apmarshall3/general-purpose-robotics-shield/PCB_V2/model3d/L298P.stp

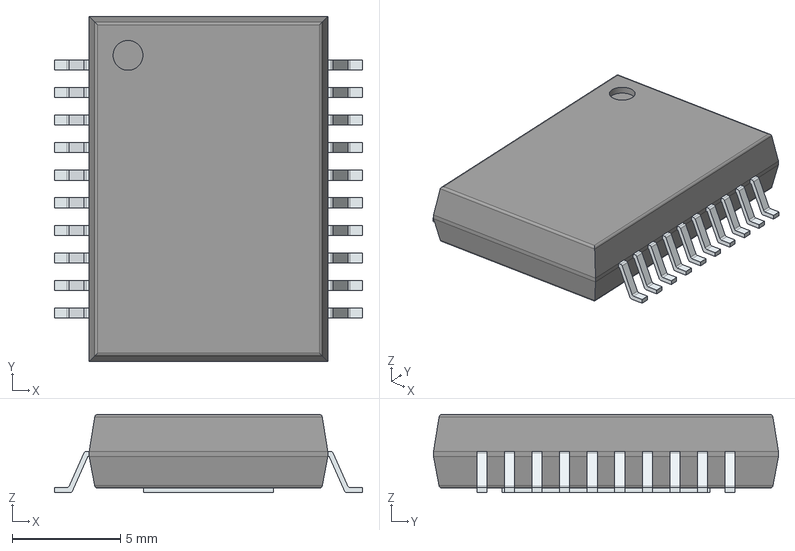
[picture p1: CAD file, 2024-03-01]
PCB_V2/model3d/L298P.stp
14.2 x 15.9 x 3.60 mm
PinsArrayLR
ThermalPad
