apmarshall3/general-purpose-robotics-shield/PCB_V2/model3d/Molex_90Grad_8er.STEP

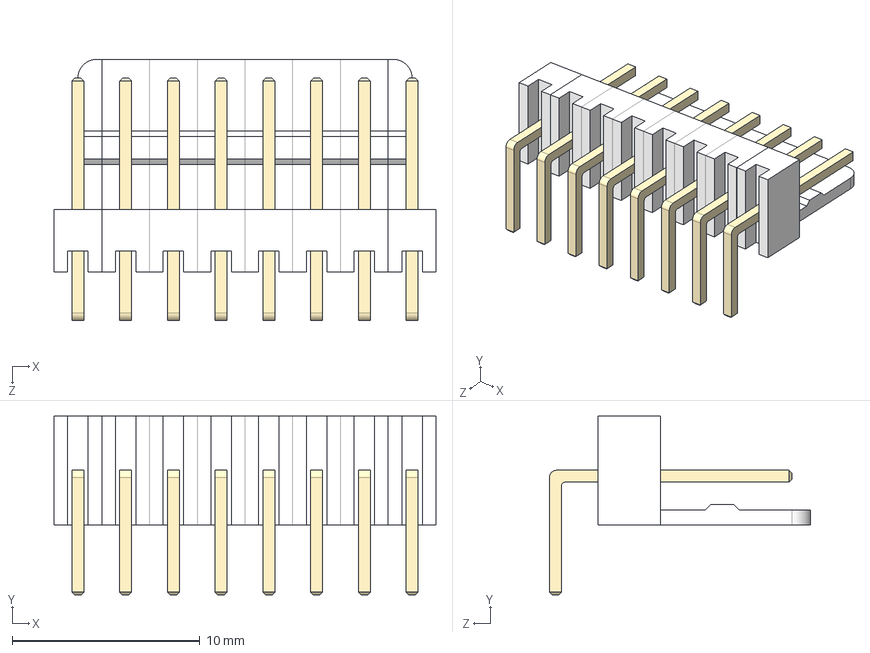
[picture p6: CAD file, 2024-02-28]
PCB_V2/model3d/Molex_90Grad_8er.STEP
20.3 x 9.52 x 13.9 mm
Molex_Stecker_90Grad_rechts
Molex_Stecker_90Grad_links
Molex_Stecker_90Grad_mitte x 6
