apmarshall3/general-purpose-robotics-shield/(list of files, cad)

Other CAD files:
PCB_V2/Shield_offset-B_Paste.dxf
PCB_V2/Shield_offset-F_Paste.dxf
