apmarshall3/general-purpose-robotics-shield/PCB_V2/Shield_offset.kicad_pcb

## KiCad design PCB_V2/Shield_offset.kicad_pcb (2026-07-02)

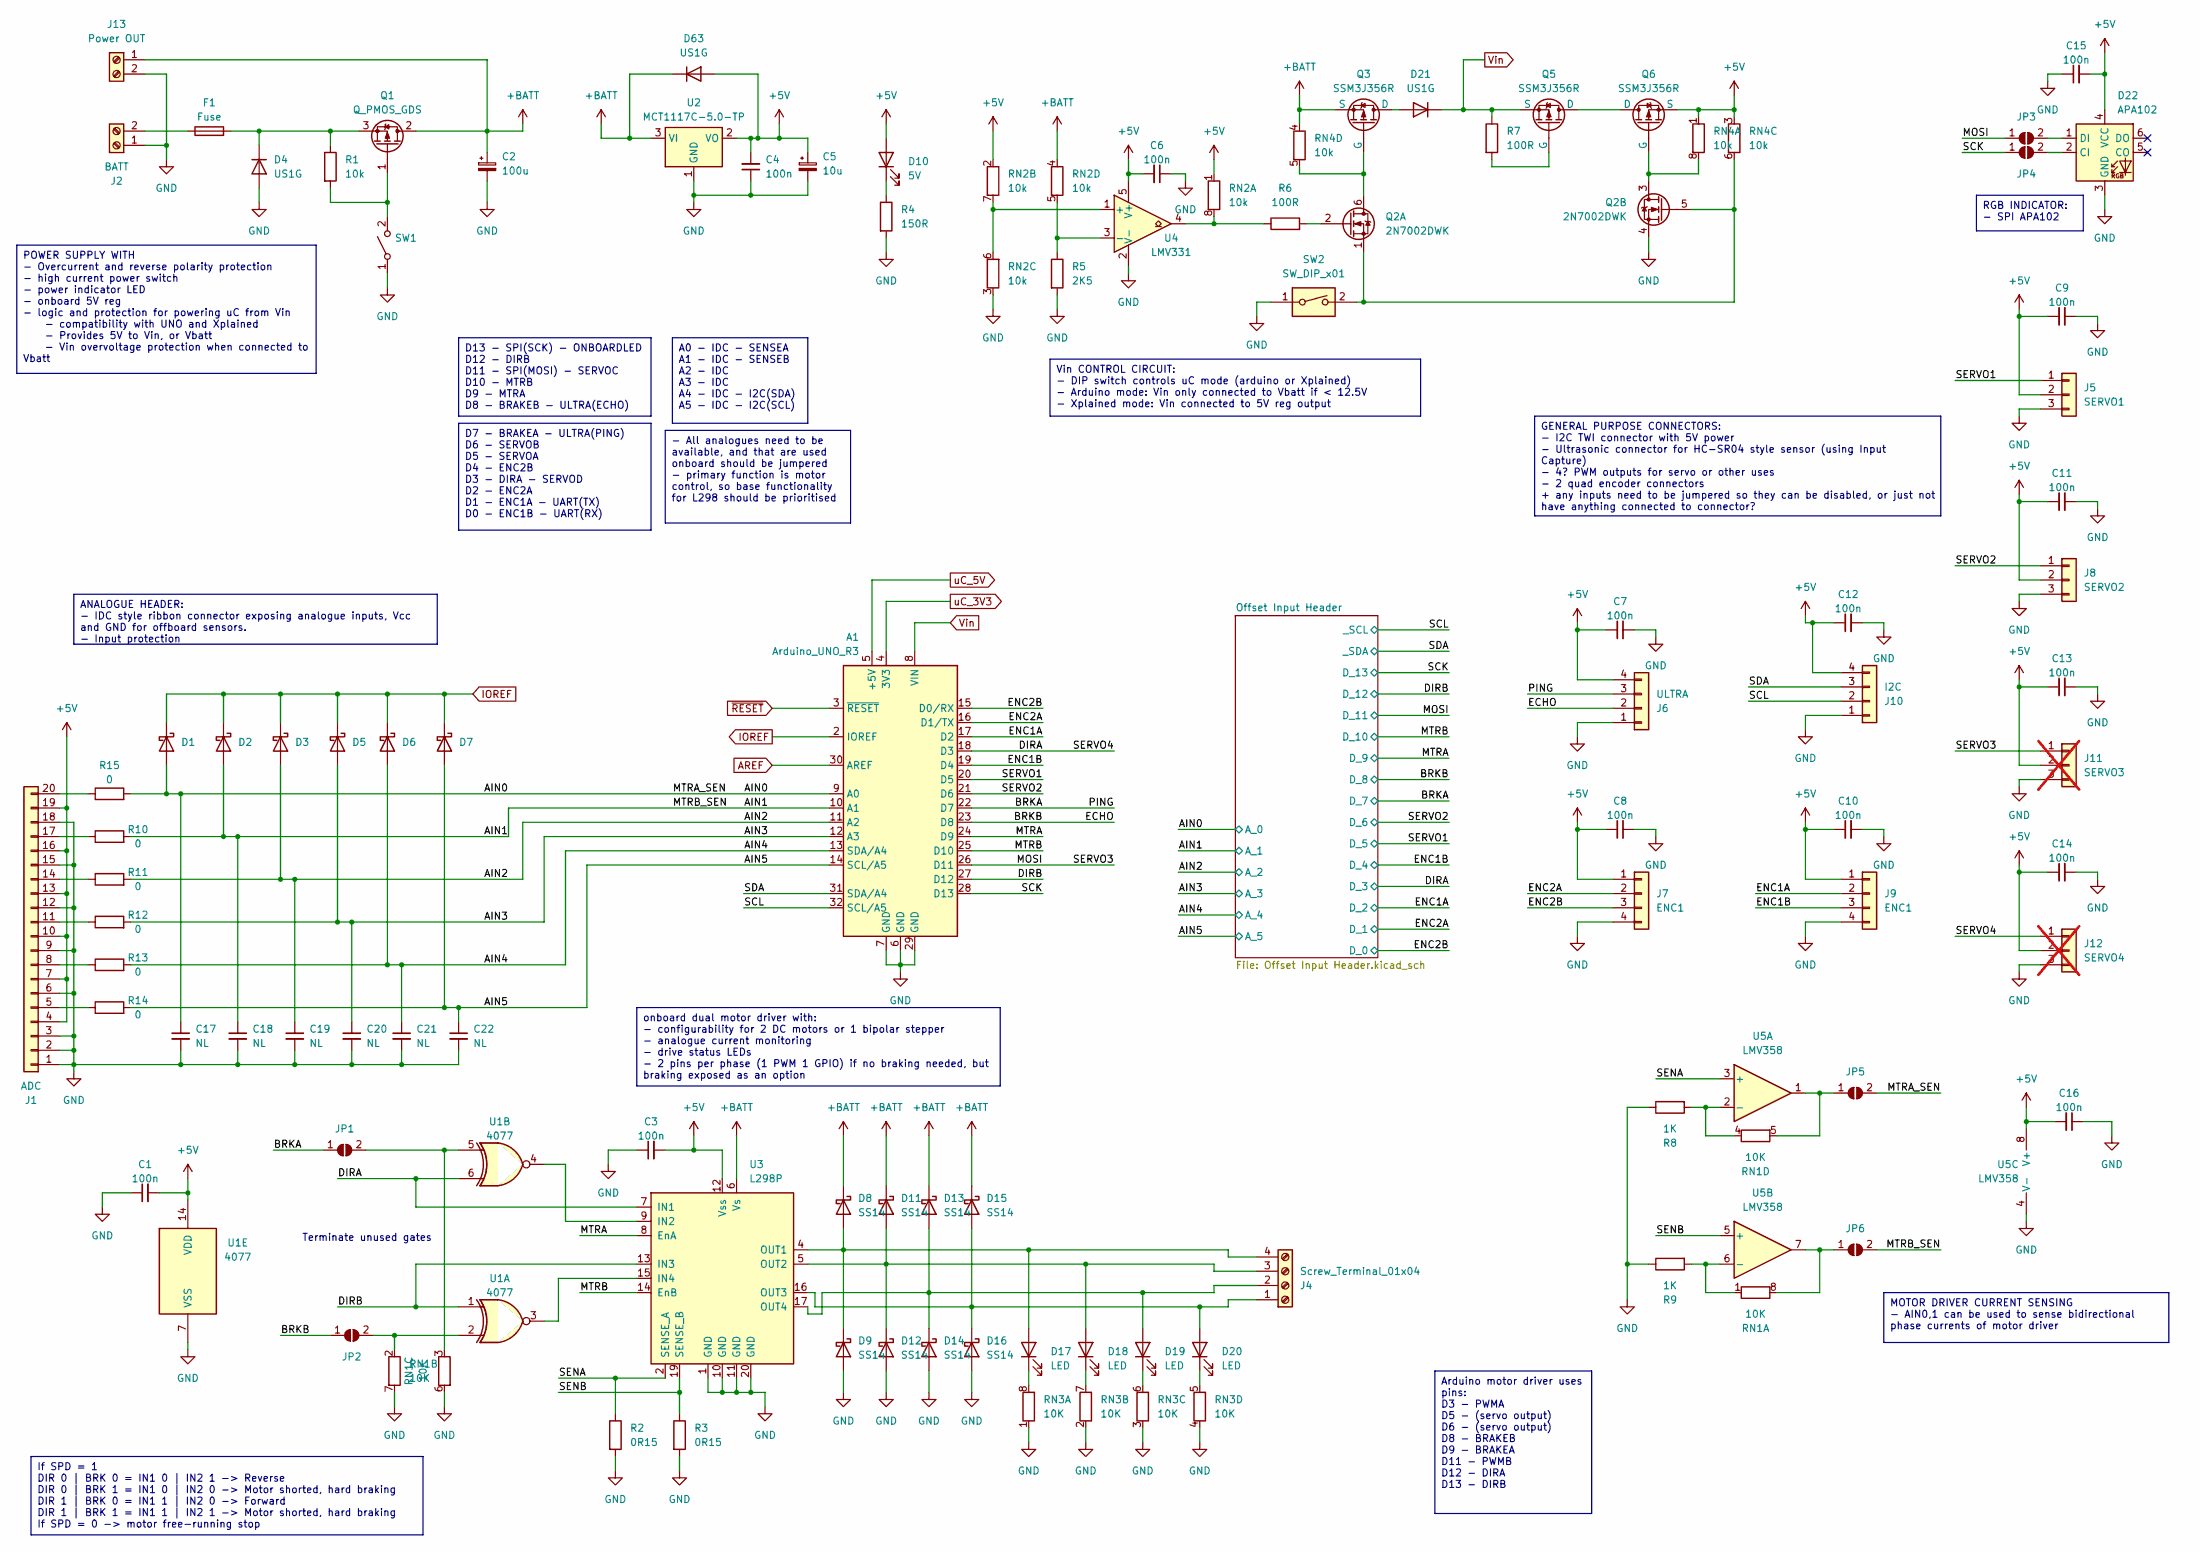
[picture p11: schematic Shield_offset.kicad_sch]

Parts:
A1: Arduino_UNO_R3
C1, C3, C4, C6, C7, C8, C9, C10, C11, C12, C13, C14, C15, C16: 100n; C_0805_2012Metric_Pad1.18x1.45mm_HandSolder
C2: 100u; CP_Elec_6.3x7.7; Manuf Part# HHXJ350ARA101MF80G
C5: 10u; CP_Elec_6.3x5.7
C17, C18, C19, C20, C21, C22: NL; C_0805_2012Metric_Pad1.18x1.45mm_HandSolder
D1, D2, D3, D5, D6, D7: CDBW140-G; D_SOD-123
D4, D21, D63: US1G; D_SMA
D8, D9, D11, D12, D13, D14, D15, D16: SS14; D_SMA
D10: 5V; LED_0805_2012Metric_Pad1.15x1.40mm_HandSolder
D17, D18, D19, D20: LED; LED_0805_2012Metric_Pad1.15x1.40mm_HandSolder
D22: APA102; LED_RGB_5050-6
F1: Fuse; Fuseholder_Clip-5x20mm_Littelfuse_445-030_Inline_P20.50x5.2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
J1: ADC; IDC-Header_2x10_P2.54mm_Vertical
J2: BATT; Amass_XT60PW-M_Kombifootprint
J4: Screw_Terminal_01x04; TerminalBlock_Phoenix_MKDS-1,5-4-5.08_1x04_P5.08mm_Horizont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
J5: SERVO1; PinHeader_1x03_P2.54mm_Vertical
J6: ULTRA; Molex_KK-254_1x04_P2.54mm_Horizontal
J7, J9: ENC1; Molex_KK-254_AE-6410-04A_1x04_P2.54mm_Vertical
J8: SERVO2; PinHeader_1x03_P2.54mm_Vertical
J10: I2C; Molex_KK-254_1x04_P2.54mm_Horizontal
J11: SERVO3; PinHeader_1x03_P2.54mm_Vertical; not fitted
J12: SERVO4; PinHeader_1x03_P2.54mm_Vertical; not fitted
J13: Power OUT; TerminalBlock_Phoenix_MKDS-1,5-2-5.08_1x02_P5.08mm_Horizont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
JP1, JP2, JP3, JP4, JP5, JP6: SolderJumper_2_Open; SolderJumper-2_P1.3mm_Open_RoundedPad1.0x1.5mm
Q1: Q_PMOS_GDS; SOT-223-3_TabPin2
Q2: 2N7002DWK; SOT-363_SC-70-6_Handsoldering
Q3, Q5, Q6: SSM3J356R; SOT-23-3
R1: 10k; R_0805_2012Metric_Pad1.20x1.40mm_HandSolder
R2, R3: 0R15; R_1206_3216Metric_Pad1.30x1.75mm_HandSolder
R4: 150R; R_0805_2012Metric_Pad1.20x1.40mm_HandSolder
R5: 2K5; R_0805_2012Metric_Pad1.20x1.40mm_HandSolder
R6, R7: 100R; R_0805_2012Metric_Pad1.20x1.40mm_HandSolder
R8, R9: 1K; R_0805_2012Metric_Pad1.20x1.40mm_HandSolder
R10, R11, R12, R13, R14, R15: 0; R_0603_1608Metric
RN1, RN3: 10K; R_Array_Convex_4x0603
RN2, RN4: 10k; R_Array_Convex_4x0603
SW1: PWR SW; SW_E-Switch_EG2219_DPDT_Angled
SW2: SW_DIP_x01; SW_DIP_SPSTx01_Slide_9.78x4.72mm_W8.61mm_P2.54mm
U1: 4077; SOIC-14_3.9x8.7mm_P1.27mm
U2: MCT1117C-5.0-TP; SOT-223-3_TabPin2
U3: L298P; SOIC127P1420X360-21N
U4: LMV331; SOT-353_SC-70-5
U5: LMV358; SOIC-8_3.9x4.9mm_P1.27mm

Connections:
+5V: C1.2, C3.2, C4.2, C5.1, C6.2, C7.1, C8.1, C9.1, C10.1, C11.1, C12.1, C13.1, C14.1, C15.2, C16.2, D10.2 (A), D22.4 (VCC), D63.2 (A), J1.4, J1.7, J1.10, J1.13, J1.16, J1.19, J5.2, J6.4, J7.1, J8.2, J9.1, J10.4, J11.2, J12.2, Q6.2 (S), RN2.1 (R1.1), RN2.2 (R2.1), RN4.1 (R1.1), RN4.3 (R3.1), U1.14 (VDD), U2.2 (VO), U3.12 (Vss), U4.5 (V+), U5.8 (V+)
+BATT: C2.1, D8.1 (K), D11.1 (K), D13.1 (K), D15.1 (K), D63.1 (K), J13.1, Q1.2 (D), Q3.2 (S), RN2.4 (R4.1), RN4.4 (R4.1), U2.3 (VI), U3.6 (Vs)
/AIN0: A1.9 (A0), C17.1, D1.2 (A), JP5.2 (B), R15.2; also elsewhere on the board
/AIN1: A1.10 (A1), C18.1, D2.2 (A), JP6.2 (B), R10.2; also elsewhere on the board
/AIN2: A1.11 (A2), C19.1, D3.2 (A), R11.2; also elsewhere on the board
/AIN3: A1.12 (A3), C20.1, D5.2 (A), R12.2; also elsewhere on the board
/AIN4: A1.13 (SDA/A4), C21.1, D6.2 (A), R13.2; also elsewhere on the board
/AIN5: A1.14 (SCL/A5), C22.1, D7.2 (A), R14.2; also elsewhere on the board
/BRKA: A1.22 (D7), J6.3, JP1.1 (A); also elsewhere on the board
/BRKB: A1.23 (D8), J6.2, JP2.1 (A); also elsewhere on the board
/DIRA: A1.18 (D3), J12.1, U1.6, U3.7 (IN1); also elsewhere on the board
/DIRB: A1.27 (D12), U1.1, U3.13 (IN3); also elsewhere on the board
/ENC1A: A1.17 (D2), J9.2; also elsewhere on the board
/ENC1B: A1.19 (D4), J9.3; also elsewhere on the board
/ENC2A: A1.16 (D1/TX), J7.2; also elsewhere on the board
/ENC2B: A1.15 (D0/RX), J7.3; also elsewhere on the board
/MOSI: A1.26 (D11), J11.1, JP3.1 (A); also elsewhere on the board
/MTRA: A1.24 (D9), U3.8 (EnA); also elsewhere on the board
/MTRB: A1.25 (D10), U3.14 (EnB); also elsewhere on the board
/SCK: A1.28 (D13), JP4.1 (A); also elsewhere on the board
/SCL: A1.32 (SCL/A5), J10.2; also elsewhere on the board
/SDA: A1.31 (SDA/A4), J10.3; also elsewhere on the board
/SENA: R2.1, U3.2 (SENSE_A), U5.3 (+)
/SENB: R3.1, U3.19 (SENSE_B), U5.5 (+)
/SERVO1: A1.20 (D5), J5.1; also elsewhere on the board
/SERVO2: A1.21 (D6), J8.1; also elsewhere on the board
AREF: A1.30 (AREF); also elsewhere on the board
GND: A1.6 (GND), A1.7 (GND), A1.29 (GND), C1.1, C2.2, C3.1, C4.1, C5.2, C6.1, C7.2, C8.2, C9.2, C10.2, C11.2, C12.2, C13.2, C14.2, C15.1, C16.1, C17.2, C18.2, C19.2, C20.2, C21.2, C22.2, D4.2 (A), D9.2 (A), D12.2 (A), D14.2 (A), D16.2 (A), D22.3 (GND), J1.1, J1.2, J1.3, J1.6, J1.9, J1.12, J1.15, J1.18, J2.1, J5.3, J6.1, J7.4, J8.3, J9.4, J10.1, J11.3, J12.3, J13.2, Q2.4 (S), R2.2, R3.2, R4.2, R5.2, R8.1, R9.1, RN1.6 (R3.2), RN1.7 (R2.2), RN2.3 (R3.1), RN3.1 (R1.1), RN3.2 (R2.1), RN3.3 (R3.1), RN3.4 (R4.1), SW1.1 (A), SW2.1, U1.7 (VSS), U2.1 (GND), U3.1 (GND), U3.10 (GND), U3.11 (GND), U3.20 (GND), U4.2 (V-), U5.4 (V-); also elsewhere on the board
IOREF: A1.2 (IOREF), D1.1 (K), D2.1 (K), D3.1 (K), D5.1 (K), D6.1 (K), D7.1 (K); also elsewhere on the board
unnamed: D4.1 (K), F1.2, Q1.3 (S), R1.1
unnamed: D10.1 (K), R4.1
unnamed: D11.2 (A), D12.1 (K), D18.2 (A), J4.3, U3.5 (OUT2)
unnamed: D13.2 (A), D14.1 (K), D19.2 (A), J4.2, U3.17 (OUT4)
unnamed: D15.2 (A), D16.1 (K), D20.2 (A), J4.1, U3.16 (OUT3)
unnamed: D8.2 (A), D9.1 (K), D17.2 (A), J4.4, U3.4 (OUT1)
unnamed: D17.1 (K), RN3.8 (R1.2)
unnamed: D18.1 (K), RN3.7 (R2.2)
unnamed: D19.1 (K), RN3.6 (R3.2)
unnamed: D20.1 (K), RN3.5 (R4.2)
unnamed: D21.2 (A), Q3.3 (D)
unnamed: D22.2 (CI), JP4.2 (B)
unnamed: D22.1 (DI), JP3.2 (B)
unnamed: J1.5, R14.1
unnamed: J1.8, R13.1
unnamed: J1.11, R12.1
unnamed: J1.14, R11.1
unnamed: J1.17, R10.1
unnamed: J1.20, R15.1
unnamed: F1.1, J2.2
unnamed: JP1.2 (B), RN1.3 (R3.1), U1.5
unnamed: JP2.2 (B), RN1.2 (R2.1), U1.2
unnamed: JP5.1 (A), RN1.5 (R4.2), U5.1
unnamed: JP6.1 (A), RN1.8 (R1.2), U5.7
unnamed: Q1.1 (G), R1.2, SW1.2 (B)
unnamed: Q2.6 (D), Q3.1 (G), RN4.5 (R4.2)
unnamed: Q2.2 (G), R6.2
unnamed: Q2.1 (S), Q2.5 (G), RN4.6 (R3.2), SW2.2
unnamed: Q2.3 (D), Q6.1 (G), RN4.8 (R1.2)
unnamed: Q5.3 (D), Q6.3 (D)
unnamed: Q5.1 (G), R7.2
unnamed: R9.2, RN1.1 (R1.1), U5.6 (-)
unnamed: R8.2, RN1.4 (R4.1), U5.2 (-)
unnamed: R6.1, RN2.8 (R1.2), U4.4
unnamed: RN2.6 (R3.2), RN2.7 (R2.2), U4.1 (+)
unnamed: R5.1, RN2.5 (R4.2), U4.3 (-)
unnamed: U1.4, U3.9 (IN2)
unnamed: U1.3, U3.15 (IN4)
Vin: A1.8 (VIN), D21.1 (K), Q5.2 (S), R7.1; also elsewhere on the board
uC_3V3: A1.4 (3V3); also elsewhere on the board
uC_5V: A1.5 (+5V); also elsewhere on the board
~RESET: A1.3 (~RESET); also elsewhere on the board

Notes on the sheet:
D7 - BRAKEA - ULTRA(PING) D6 - SERVOB D5 - SERVOA D4 - ENC2B D3 - DIRA - SERVOD D2 - ENC2A D1 - ENC1A - UART(TX) D0 - ENC1B - UART(RX)
D13 - SPI(SCK) - ONBOARDLED D12 - DIRB D11 - SPI(MOSI) - SERVOC D10 - MTRB D9 - MTRA D8 - BRAKEB - ULTRA(ECHO)
RGB INDICATOR: - SPI APA102
Vin CONTROL CIRCUIT: - DIP switch controls uC mode (arduino or Xplained) - Arduino mode: Vin only connected to Vbatt if < 12.5V - Xplained mode: Vin connected to 5V reg output
Arduino motor driver uses pins: D3 - PWMA D5 - (servo output) D6 - (servo output) D8 - BRAKEB D9 - BRAKEA D11 - PWMB D12 - DIRA D13 - DIRB
- All analogues need to be available, and that are used onboard should be jumpered - primary function is motor control, so base functionality for L298 should be prioritised
POWER SUPPLY WITH - Overcurrent and reverse polarity protection - high current power switch - power indicator LED - onboard 5V reg - logic and protection for powering uC from Vin - compatibility with UNO and Xplained - Provides 5V to Vin, or Vbatt - Vin overvoltage protection when connected to Vbatt
A0 - IDC - SENSEA A1 - IDC - SENSEB A2 - IDC A3 - IDC A4 - IDC - I2C(SDA) A5 - IDC - I2C(SCL)
ANALOGUE HEADER: - IDC style ribbon connector exposing analogue inputs, Vcc and GND for offboard sensors. - Input protection
If SPD = 1 DIR 0 | BRK 0 = IN1 0 | IN2 1 -> Reverse DIR 0 | BRK 1 = IN1 0 | IN2 0 -> Motor shorted, hard braking DIR 1 | BRK 0 = IN1 1 | IN2 0 -> Forward DIR 1 | BRK 1 = IN1 1 | IN2 1 -> Motor shorted, hard braking If SPD = 0 -> motor free-running stop
onboard dual motor driver with: - configurability for 2 DC motors or 1 bipolar stepper - analogue current monitoring - drive status LEDs - 2 pins per phase (1 PWM 1 GPIO) if no braking needed, but braking exposed as an option
GENERAL PURPOSE CONNECTORS: - I2C TWI connector with 5V power - Ultrasonic connector for HC-SR04 style sensor (using Input Capture) - 4? PWM outputs for servo or other uses - 2 quad encoder connectors + any inputs need to be jumpered so they can be disabled, or just not have anything connected to c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
MOTOR DRIVER CURRENT SENSING - AIN0,1 can be used to sense bidirectional phase currents of motor driver
Terminate unused gates

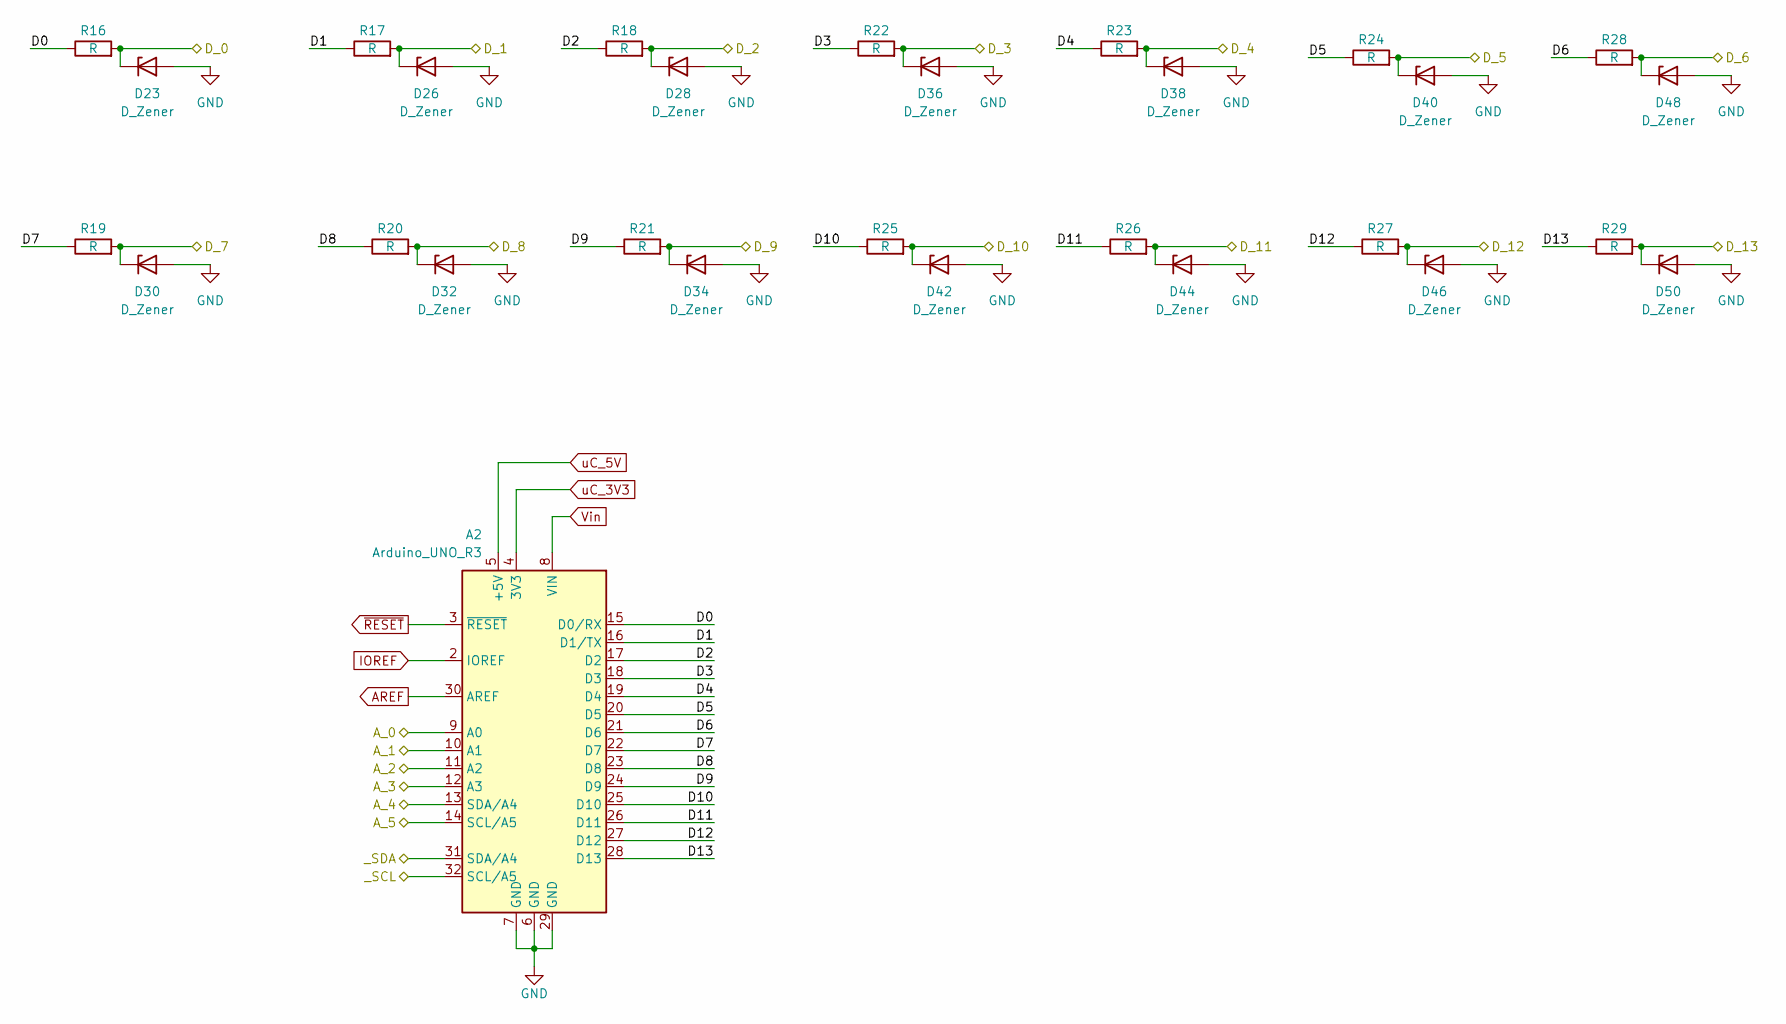
[picture p12: schematic Offset Input Header.kicad_sch]

Parts:
A2: Arduino_UNO_R3
D23, D26, D28, D30, D32, D34, D36, D38, D40, D42, D44, D46, D48, D50: D_Zener; D_SOD-123
R16, R17, R18, R19, R20, R21, R22, R23, R24, R25, R26, R27, R28, R29: R; R_0805_2012Metric

Connections:
/AIN0: A2.9 (A0); also elsewhere on the board
/AIN1: A2.10 (A1); also elsewhere on the board
/AIN2: A2.11 (A2); also elsewhere on the board
/AIN3: A2.12 (A3); also elsewhere on the board
/AIN4: A2.13 (SDA/A4); also elsewhere on the board
/AIN5: A2.14 (SCL/A5); also elsewhere on the board
/BRKA: D30.1 (K), R19.2; also elsewhere on the board
/BRKB: D32.1 (K), R20.2; also elsewhere on the board
/DIRA: D36.1 (K), R22.2; also elsewhere on the board
/DIRB: D46.1 (K), R27.2; also elsewhere on the board
/ENC1A: D28.1 (K), R18.2; also elsewhere on the board
/ENC1B: D38.1 (K), R23.2; also elsewhere on the board
/ENC2A: D26.1 (K), R17.2; also elsewhere on the board
/ENC2B: D23.1 (K), R16.2; also elsewhere on the board
/MOSI: D44.1 (K), R26.2; also elsewhere on the board
/MTRA: D34.1 (K), R21.2; also elsewhere on the board
/MTRB: D42.1 (K), R25.2; also elsewhere on the board
/Offset Input Header/D0: A2.15 (D0/RX), R16.1
/Offset Input Header/D1: A2.16 (D1/TX), R17.1
/Offset Input Header/D2: A2.17 (D2), R18.1
/Offset Input Header/D3: A2.18 (D3), R22.1
/Offset Input Header/D4: A2.19 (D4), R23.1
/Offset Input Header/D5: A2.20 (D5), R24.1
/Offset Input Header/D6: A2.21 (D6), R28.1
/Offset Input Header/D7: A2.22 (D7), R19.1
/Offset Input Header/D8: A2.23 (D8), R20.1
/Offset Input Header/D9: A2.24 (D9), R21.1
/Offset Input Header/D10: A2.25 (D10), R25.1
/Offset Input Header/D11: A2.26 (D11), R26.1
/Offset Input Header/D12: A2.27 (D12), R27.1
/Offset Input Header/D13: A2.28 (D13), R29.1
/SCK: D50.1 (K), R29.2; also elsewhere on the board
/SCL: A2.32 (SCL/A5); also elsewhere on the board
/SDA: A2.31 (SDA/A4); also elsewhere on the board
/SERVO1: D40.1 (K), R24.2; also elsewhere on the board
/SERVO2: D48.1 (K), R28.2; also elsewhere on the board
AREF: A2.30 (AREF); also elsewhere on the board
GND: A2.6 (GND), A2.7 (GND), A2.29 (GND), D23.2 (A), D26.2 (A), D28.2 (A), D30.2 (A), D32.2 (A), D34.2 (A), D36.2 (A), D38.2 (A), D40.2 (A), D42.2 (A), D44.2 (A), D46.2 (A), D48.2 (A), D50.2 (A); also elsewhere on the board
IOREF: A2.2 (IOREF); also elsewhere on the board
Vin: A2.8 (VIN); also elsewhere on the board
uC_3V3: A2.4 (3V3); also elsewhere on the board
uC_5V: A2.5 (+5V); also elsewhere on the board
~RESET: A2.3 (~RESET); also elsewhere on the board

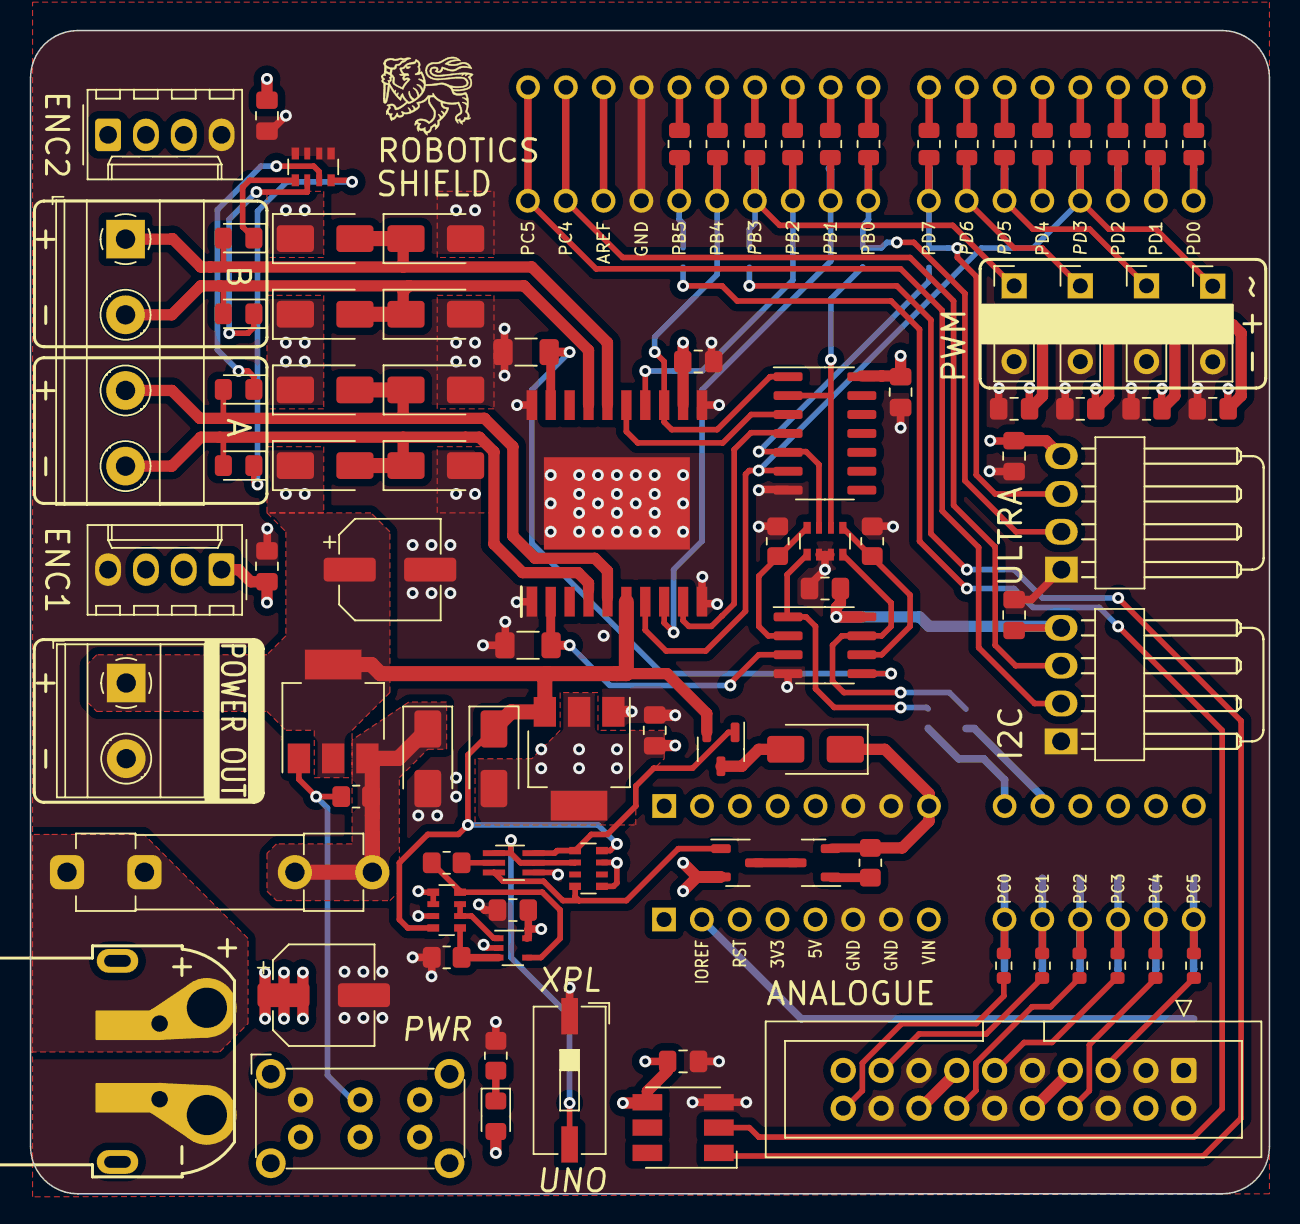
[picture p13: board Shield_offset.kicad_pcb from above]

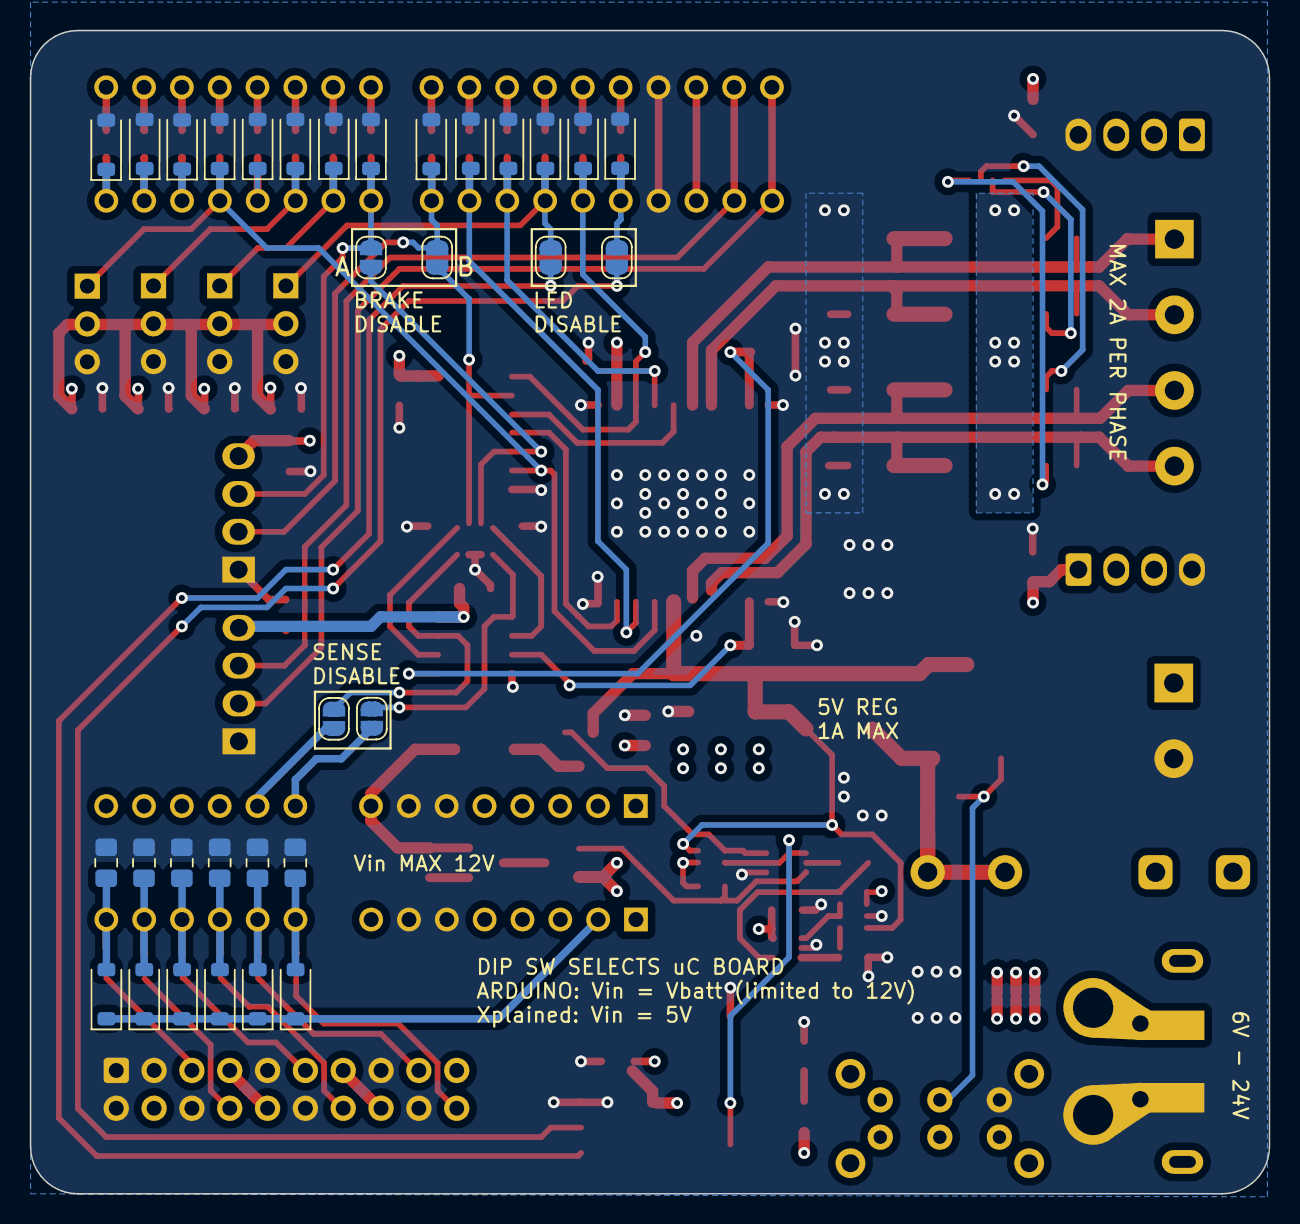
[picture p14: board Shield_offset.kicad_pcb from below]

Board: 4 copper layers, 83.2 x 78.1 mm, 125 parts (34 on the bottom side), 85 nets.
