apmarshall3/general-purpose-robotics-shield/PCB_V1/Shield.kicad_pcb

## KiCad design PCB_V1/Shield.kicad_pcb (2024-03-20, an earlier design)

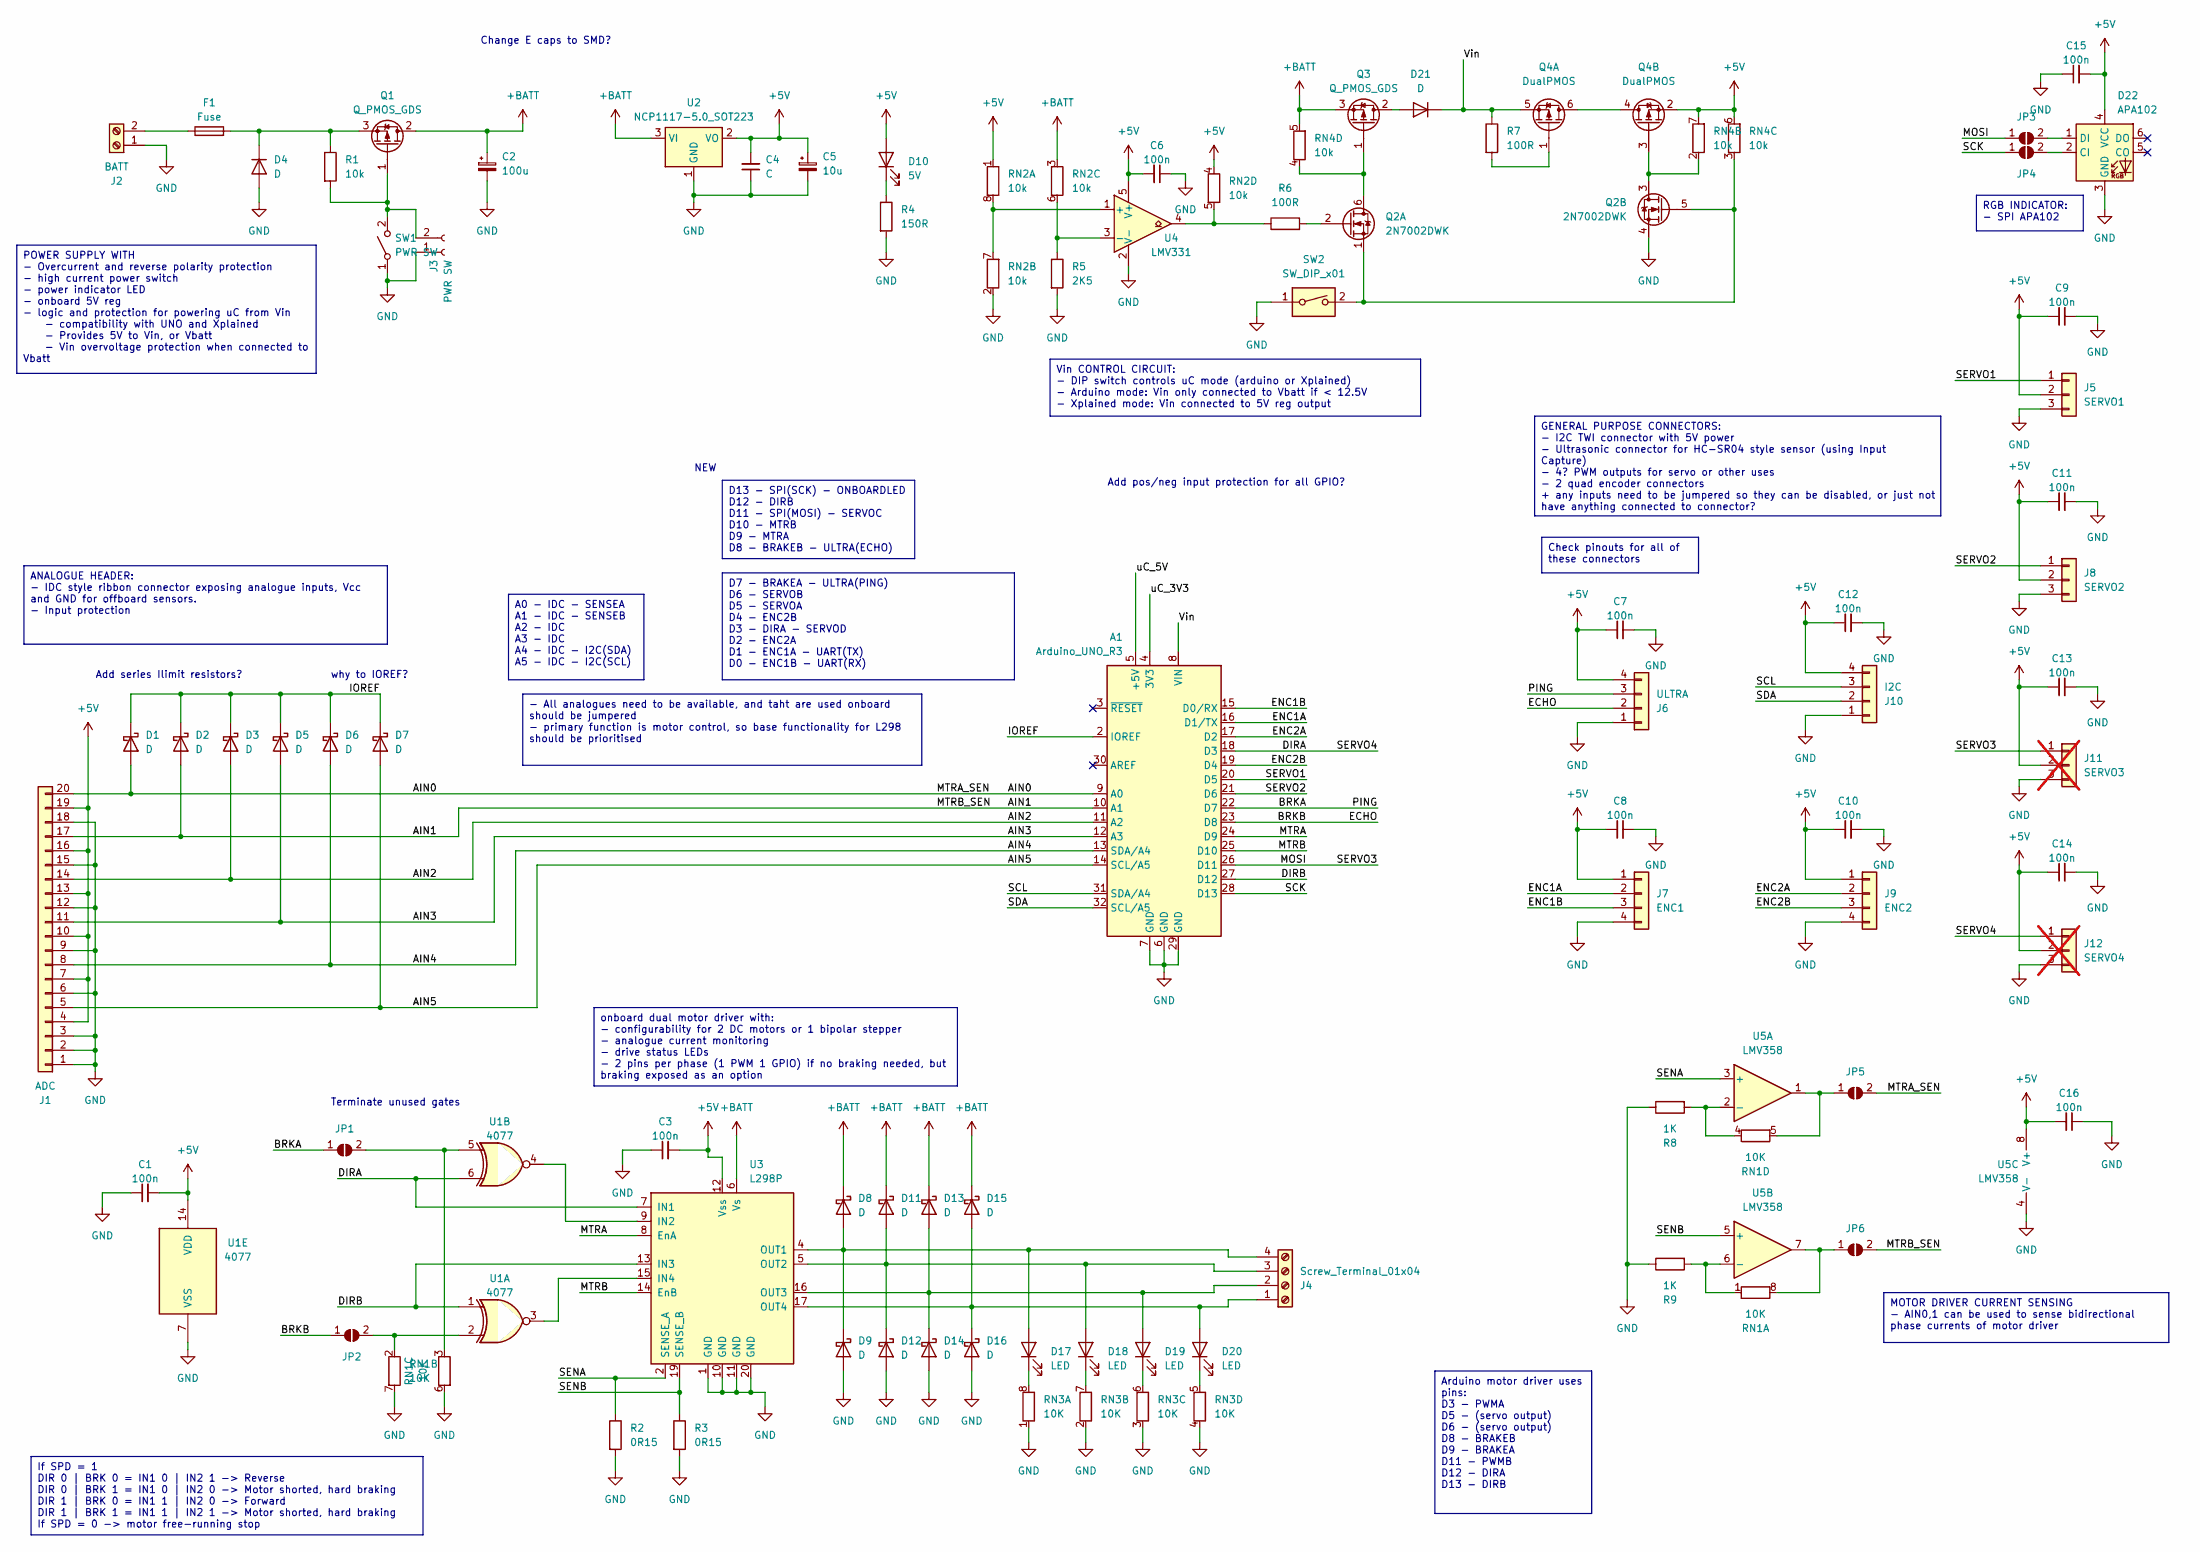
[picture p15: schematic Shield.kicad_sch]

Parts:
A1: Arduino_UNO_R3
C1, C3, C6, C7, C8, C9, C10, C11, C12, C13, C14, C15, C16: 100n; C_0805_2012Metric_Pad1.18x1.45mm_HandSolder
C2: 100u; CP_Radial_D5.0mm_P2.50mm
C4: C; C_0805_2012Metric_Pad1.18x1.45mm_HandSolder
C5: 10u; CP_Radial_D5.0mm_P2.50mm
D1, D2, D3, D4, D5, D6, D7, D8, D9, D11, D12, D13, D14, D15, D16, D21: D; D_SOD-123
D10: 5V; LED_0805_2012Metric_Pad1.15x1.40mm_HandSolder
D17, D18, D19, D20: LED; LED_0805_2012Metric_Pad1.15x1.40mm_HandSolder
D22: APA102; LED_RGB_5050-6
F1: Fuse; Fuseholder_Clip-5x20mm_Littelfuse_445-030_Inline_P20.50x5.2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
J1: ADC; IDC-Header_2x10_P2.54mm_Horizontal
J2: BATT; Amass_XT60PW-M_Kombifootprint
J3: PWR SW; PinHeader_1x02_P2.54mm_Vertical
J4: Screw_Terminal_01x04; TerminalBlock_bornier-4_P5.08mm
J5: SERVO1; PinHeader_1x03_P2.54mm_Vertical
J6: ULTRA; Molex_KK-254_1x04_P2.54mm_Horizontal
J7: ENC1; Molex_KK-254_AE-6410-04A_1x04_P2.54mm_Vertical
J8: SERVO2; PinHeader_1x03_P2.54mm_Vertical
J9: ENC2; Molex_KK-254_AE-6410-04A_1x04_P2.54mm_Vertical
J10: I2C; Molex_KK-254_1x04_P2.54mm_Horizontal
J11: SERVO3; PinHeader_1x03_P2.54mm_Vertical; not fitted
J12: SERVO4; PinHeader_1x03_P2.54mm_Vertical; not fitted
JP1, JP2, JP3, JP4, JP5, JP6: SolderJumper_2_Open; SolderJumper-2_P1.3mm_Open_RoundedPad1.0x1.5mm
Q1: Q_PMOS_GDS; SOT-223-3_TabPin2
Q2: 2N7002DWK; SOT-363_SC-70-6_Handsoldering
Q3: Q_PMOS_GDS; SOT-323_SC-70_Handsoldering
Q4: DualPMOS; SOT-23-6_Handsoldering
R1: 10k; R_0805_2012Metric_Pad1.20x1.40mm_HandSolder
R2, R3: 0R15; R_1206_3216Metric_Pad1.30x1.75mm_HandSolder
R4: 150R; R_0805_2012Metric_Pad1.20x1.40mm_HandSolder
R5: 2K5; R_0805_2012Metric_Pad1.20x1.40mm_HandSolder
R6, R7: 100R; R_0805_2012Metric_Pad1.20x1.40mm_HandSolder
R8, R9: 1K; R_0805_2012Metric_Pad1.20x1.40mm_HandSolder
RN1, RN3: 10K; R_Array_Convex_4x0603
RN2, RN4: 10k; R_Array_Convex_4x0603
SW1: PWR SW; SW_E-Switch_EG2219_DPDT_Angled
SW2: SW_DIP_x01; SW_DIP_SPSTx01_Slide_9.78x4.72mm_W8.61mm_P2.54mm
U1: 4077; SOIC-14_3.9x8.7mm_P1.27mm
U2: NCP1117-5.0_SOT223; SOT-223-3_TabPin2
U3: L298P; SOIC127P1420X360-21N
U4: LMV331; SOT-23-5
U5: LMV358; SOIC-8_3.9x4.9mm_P1.27mm

Connections:
+5V: C1.2, C3.2, C4.2, C5.1, C6.2, C7.1, C8.1, C9.1, C10.1, C11.1, C12.1, C13.1, C14.1, C15.2, C16.2, D10.2 (A), D22.4 (VCC), J1.4, J1.7, J1.10, J1.13, J1.16, J1.19, J5.2, J6.4, J7.1, J8.2, J9.1, J10.4, J11.2, J12.2, Q4.2 (S), RN2.1 (R1.1), RN2.4 (R4.1), RN4.6 (R3.2), RN4.7 (R2.2), U1.14 (VDD), U2.2 (VO), U3.12 (Vss), U4.5 (V+), U5.8 (V+)
+BATT: C2.1, D8.1 (K), D11.1 (K), D13.1 (K), D15.1 (K), Q1.2 (D), Q3.3 (S), RN2.3 (R3.1), RN4.5 (R4.2), U2.3 (VI), U3.6 (Vs)
/AIN0: A1.9 (A0), D1.2 (A), J1.20, JP5.2 (B)
/AIN1: A1.10 (A1), D2.2 (A), J1.17, JP6.2 (B)
/AIN2: A1.11 (A2), D3.2 (A), J1.14
/AIN3: A1.12 (A3), D5.2 (A), J1.11
/AIN4: A1.13 (SDA/A4), D6.2 (A), J1.8
/AIN5: A1.14 (SCL/A5), D7.2 (A), J1.5
/BRKA: A1.22 (D7), J6.3, JP1.1 (A)
/BRKB: A1.23 (D8), J6.2, JP2.1 (A)
/DIRA: A1.18 (D3), J12.1, U1.6, U3.7 (IN1)
/DIRB: A1.27 (D12), U1.1, U3.13 (IN3)
/ENC1A: A1.16 (D1/TX), J7.2
/ENC1B: A1.15 (D0/RX), J7.3
/ENC2A: A1.17 (D2), J9.2
/ENC2B: A1.19 (D4), J9.3
/IOREF: A1.2 (IOREF), D1.1 (K), D2.1 (K), D3.1 (K), D5.1 (K), D6.1 (K), D7.1 (K)
/MOSI: A1.26 (D11), J11.1, JP3.1 (A)
/MTRA: A1.24 (D9), U3.8 (EnA)
/MTRB: A1.25 (D10), U3.14 (EnB)
/SCK: A1.28 (D13), JP4.1 (A)
/SCL: A1.31 (SDA/A4), J10.3
/SDA: A1.32 (SCL/A5), J10.2
/SENA: R2.1, U3.2 (SENSE_A), U5.3 (+)
/SENB: R3.1, U3.19 (SENSE_B), U5.5 (+)
/SERVO1: A1.20 (D5), J5.1
/SERVO2: A1.21 (D6), J8.1
/Vin: A1.8 (VIN), D21.1 (K), Q4.5 (S), R7.1
/uC_3V3: A1.4 (3V3)
/uC_5V: A1.5 (+5V)
GND: A1.6 (GND), A1.7 (GND), A1.29 (GND), C1.1, C2.2, C3.1, C4.1, C5.2, C6.1, C7.2, C8.2, C9.2, C10.2, C11.2, C12.2, C13.2, C14.2, C15.1, C16.1, D4.2 (A), D9.2 (A), D12.2 (A), D14.2 (A), D16.2 (A), D22.3 (GND), J1.1, J1.2, J1.3, J1.6, J1.9, J1.12, J1.15, J1.18, J2.1, J3.1, J5.3, J6.1, J7.4, J8.3, J9.4, J10.1, J11.3, J12.3, Q2.4 (S), R2.2, R3.2, R4.2, R5.2, R8.1, R9.1, RN1.6 (R3.2), RN1.7 (R2.2), RN2.2 (R2.1), RN3.1 (R1.1), RN3.2 (R2.1), RN3.3 (R3.1), RN3.4 (R4.1), SW1.1 (A), SW2.1, U1.7 (VSS), U2.1 (GND), U3.1 (GND), U3.10 (GND), U3.11 (GND), U3.20 (GND), U4.2 (V-), U5.4 (V-)
unnamed: D4.1 (K), F1.2, Q1.3 (S), R1.1
unnamed: D10.1 (K), R4.1
unnamed: D11.2 (A), D12.1 (K), D18.2 (A), J4.3, U3.5 (OUT2)
unnamed: D13.2 (A), D14.1 (K), D19.2 (A), J4.2, U3.16 (OUT3)
unnamed: D15.2 (A), D16.1 (K), D20.2 (A), J4.1, U3.17 (OUT4)
unnamed: D8.2 (A), D9.1 (K), D17.2 (A), J4.4, U3.4 (OUT1)
unnamed: D17.1 (K), RN3.8 (R1.2)
unnamed: D18.1 (K), RN3.7 (R2.2)
unnamed: D19.1 (K), RN3.6 (R3.2)
unnamed: D20.1 (K), RN3.5 (R4.2)
unnamed: D21.2 (A), Q3.2 (D)
unnamed: D22.2 (CI), JP4.2 (B)
unnamed: D22.1 (DI), JP3.2 (B)
unnamed: F1.1, J2.2
unnamed: J3.2, Q1.1 (G), R1.2, SW1.2 (B)
unnamed: JP1.2 (B), RN1.3 (R3.1), U1.5
unnamed: JP2.2 (B), RN1.2 (R2.1), U1.2
unnamed: JP5.1 (A), RN1.5 (R4.2), U5.1
unnamed: JP6.1 (A), RN1.8 (R1.2), U5.7
unnamed: Q2.6 (D), Q3.1 (G), RN4.4 (R4.1)
unnamed: Q2.2 (G), R6.2
unnamed: Q2.1 (S), Q2.5 (G), RN4.3 (R3.1), SW2.2
unnamed: Q2.3 (D), Q4.3 (G), RN4.2 (R2.1)
unnamed: Q4.4 (D), Q4.6 (D)
unnamed: Q4.1 (G), R7.2
unnamed: R9.2, RN1.1 (R1.1), U5.6 (-)
unnamed: R8.2, RN1.4 (R4.1), U5.2 (-)
unnamed: RN2.7 (R2.2), RN2.8 (R1.2), U4.1 (+)
unnamed: R5.1, RN2.6 (R3.2), U4.3 (-)
unnamed: R6.1, RN2.5 (R4.2), U4.4
unnamed: U1.4, U3.9 (IN2)
unnamed: U1.3, U3.15 (IN4)

Notes on the sheet:
D7 - BRAKEA - ULTRA(PING) D6 - SERVOB D5 - SERVOA D4 - ENC2B D3 - DIRA - SERVOD D2 - ENC2A D1 - ENC1A - UART(TX) D0 - ENC1B - UART(RX)
D13 - SPI(SCK) - ONBOARDLED D12 - DIRB D11 - SPI(MOSI) - SERVOC D10 - MTRB D9 - MTRA D8 - BRAKEB - ULTRA(ECHO)
RGB INDICATOR: - SPI APA102
Vin CONTROL CIRCUIT: - DIP switch controls uC mode (arduino or Xplained) - Arduino mode: Vin only connected to Vbatt if < 12.5V - Xplained mode: Vin connected to 5V reg output
Check pinouts for all of these connectors
Arduino motor driver uses pins: D3 - PWMA D5 - (servo output) D6 - (servo output) D8 - BRAKEB D9 - BRAKEA D11 - PWMB D12 - DIRA D13 - DIRB
- All analogues need to be available, and taht are used onboard should be jumpered - primary function is motor control, so base functionality for L298 should be prioritised
POWER SUPPLY WITH - Overcurrent and reverse polarity protection - high current power switch - power indicator LED - onboard 5V reg - logic and protection for powering uC from Vin - compatibility with UNO and Xplained - Provides 5V to Vin, or Vbatt - Vin overvoltage protection when connected to Vbatt
A0 - IDC - SENSEA A1 - IDC - SENSEB A2 - IDC A3 - IDC A4 - IDC - I2C(SDA) A5 - IDC - I2C(SCL)
ANALOGUE HEADER: - IDC style ribbon connector exposing analogue inputs, Vcc and GND for offboard sensors. - Input protection
If SPD = 1 DIR 0 | BRK 0 = IN1 0 | IN2 1 -> Reverse DIR 0 | BRK 1 = IN1 0 | IN2 0 -> Motor shorted, hard braking DIR 1 | BRK 0 = IN1 1 | IN2 0 -> Forward DIR 1 | BRK 1 = IN1 1 | IN2 1 -> Motor shorted, hard braking If SPD = 0 -> motor free-running stop
onboard dual motor driver with: - configurability for 2 DC motors or 1 bipolar stepper - analogue current monitoring - drive status LEDs - 2 pins per phase (1 PWM 1 GPIO) if no braking needed, but braking exposed as an option
GENERAL PURPOSE CONNECTORS: - I2C TWI connector with 5V power - Ultrasonic connector for HC-SR04 style sensor (using Input Capture) - 4? PWM outputs for servo or other uses - 2 quad encoder connectors + any inputs need to be jumpered so they can be disabled, or just not have anything connected to c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
MOTOR DRIVER CURRENT SENSING - AIN0,1 can be used to sense bidirectional phase currents of motor driver
Add series Ilimit resistors?
why to IOREF?
NEW
Terminate unused gates
Add pos/neg input protection for all GPIO?
Change E caps to SMD?
