apmarshall3/general-purpose-robotics-shield/PCB_V1/Shield.kicad_pcb

## KiCad design PCB_V1/Shield.kicad_pcb (continued)

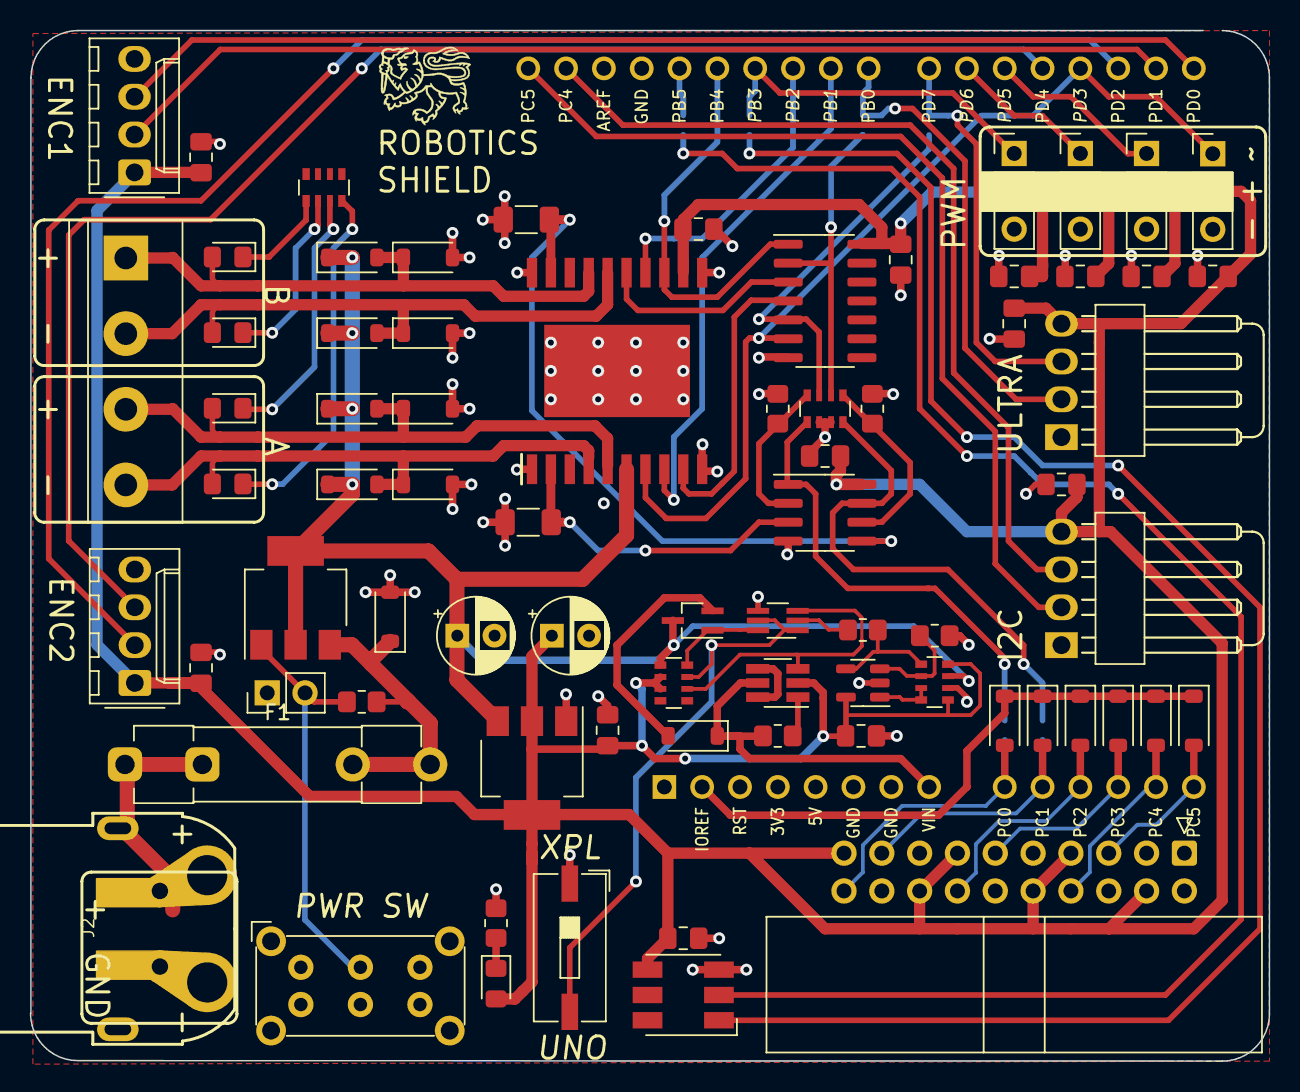
[picture p16: board Shield.kicad_pcb from above]

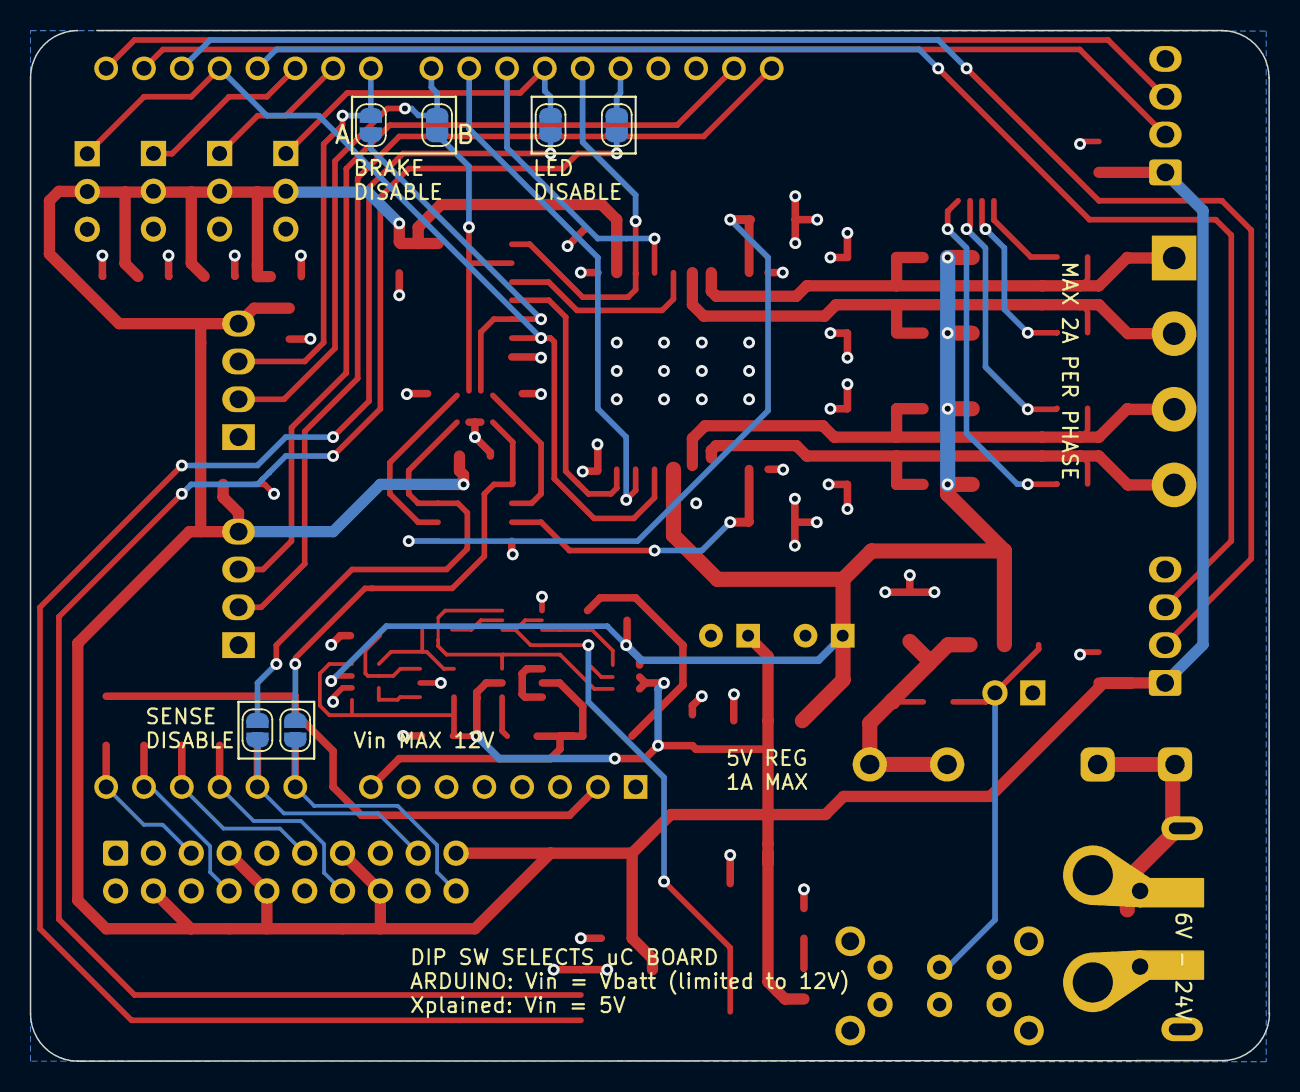
[picture p17: board Shield.kicad_pcb from below]

Board: 2 copper layers, 83.2 x 69.2 mm, 82 parts (7 on the bottom side), 61 nets.
