apmarshall3/general-purpose-robotics-shield/(commit log)

2024-03-01 Tidied schematic and layout, added indicators and silkscreen notes
    [Shield.kicad_pcb, Shield.kicad_sch]
2024-03-01 Fixed links between schem and pcb, re-added annotation, updated L298 footprint and updated layout
    [L298P.stp, Shield.kicad_pcb, Shield.kicad_sch]
2024-03-05 Added comment
    [Shield.kicad_sch]
2024-03-20 update to v2
    Update to V2 with offset header
    [L298P.stp, Molex_90Grad_10er.STEP, Molex_90Grad_12er.STEP, Molex_90Grad_2er.STEP, Molex_90Grad_3er.STEP, Molex_90Grad_4er.STEP, Molex_90Grad_5er.STEP, Molex_90Grad_6er.STEP]
2024-03-21 Minor changes to layout
    fixed overlapping silk and courtyards
    tweaked track layouts to clear disconencted edges and imporve some clearances
    fixed board outline
    [Shield_offset.kicad_pcb, Shield_offset.kicad_sch]
2024-03-21 Update
    Added gnd via's, and caps for LP filter on analog in's
    [Shield_offset.kicad_pcb, Shield_offset.kicad_sch]
2024-04-09 updates
    Bug fixes
    [Shield_offset.csv, Shield_offset.kicad_pcb, Shield_offset.kicad_sch]
2024-04-11 V2 update
    Foot prints, component selection, etc.
    [Shield_offset.kicad_pcb, Shield_offset.kicad_sch]
2024-04-12 Tidied schematic and removed old comments
    [Offset Input Header.kicad_sch, Shield_offset.kicad_sch]
2024-04-12 Changed to vertical connector
    [Shield_offset.kicad_sch]
2024-04-12 Minor changes to layout
    Made placement of connectors more consistent.
    Relocated SMT electrolytic caps to allow more space
    Made IN1 layer 5V
    Tidied routing of motor driver outputs and swapped to using pours. Moved vias out from under components.
    Adjusted power supply component placement to allow more space and smaller loop areas.
    [Shield_offset.kicad_pcb]
2024-04-12 Swapped ENC1 and ENC2 so they match the motor they are next to
    [Shield_offset.kicad_sch]
2024-04-12 Layout changes
    Rearranged power supply components to better use space, removed components where possible from gap between offset headers.
    Moved offset headers slightly to become aligned.
    Added copper pours for high current nets
    Removed F.Cu 5V tracks, inner layer plane is now used instead.
    Swapped ENC1 and ENC2 to be consistent with motor phases.
    Added silkscreen indicators for analogue, and updated power output header silk to match others.
    [Shield_offset.kicad_pcb]
2026-07-02 Paste layer dxf
    create screen for pasting
    [Shield_offset-B_Paste.dxf, Shield_offset-F_Paste.dxf, Shield_offset.kicad_pcb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]
